Wren6991/RISCBoy-180/ip/gf180mcu_name_plate/image/name_plate.png

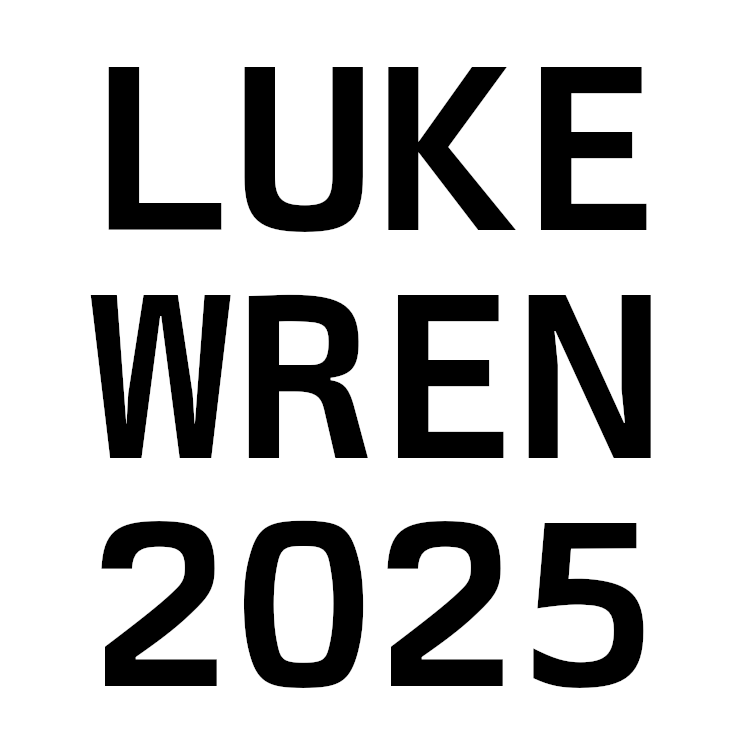
ip/gf180mcu_name_plate/image/name_plate.png
