Wren6991/RISCBoy-180/pcb/bringup/rb180-bringup.kicad_sch

## KiCad design pcb/bringup/rb180-bringup.kicad_sch (2026-06-28, an earlier design)

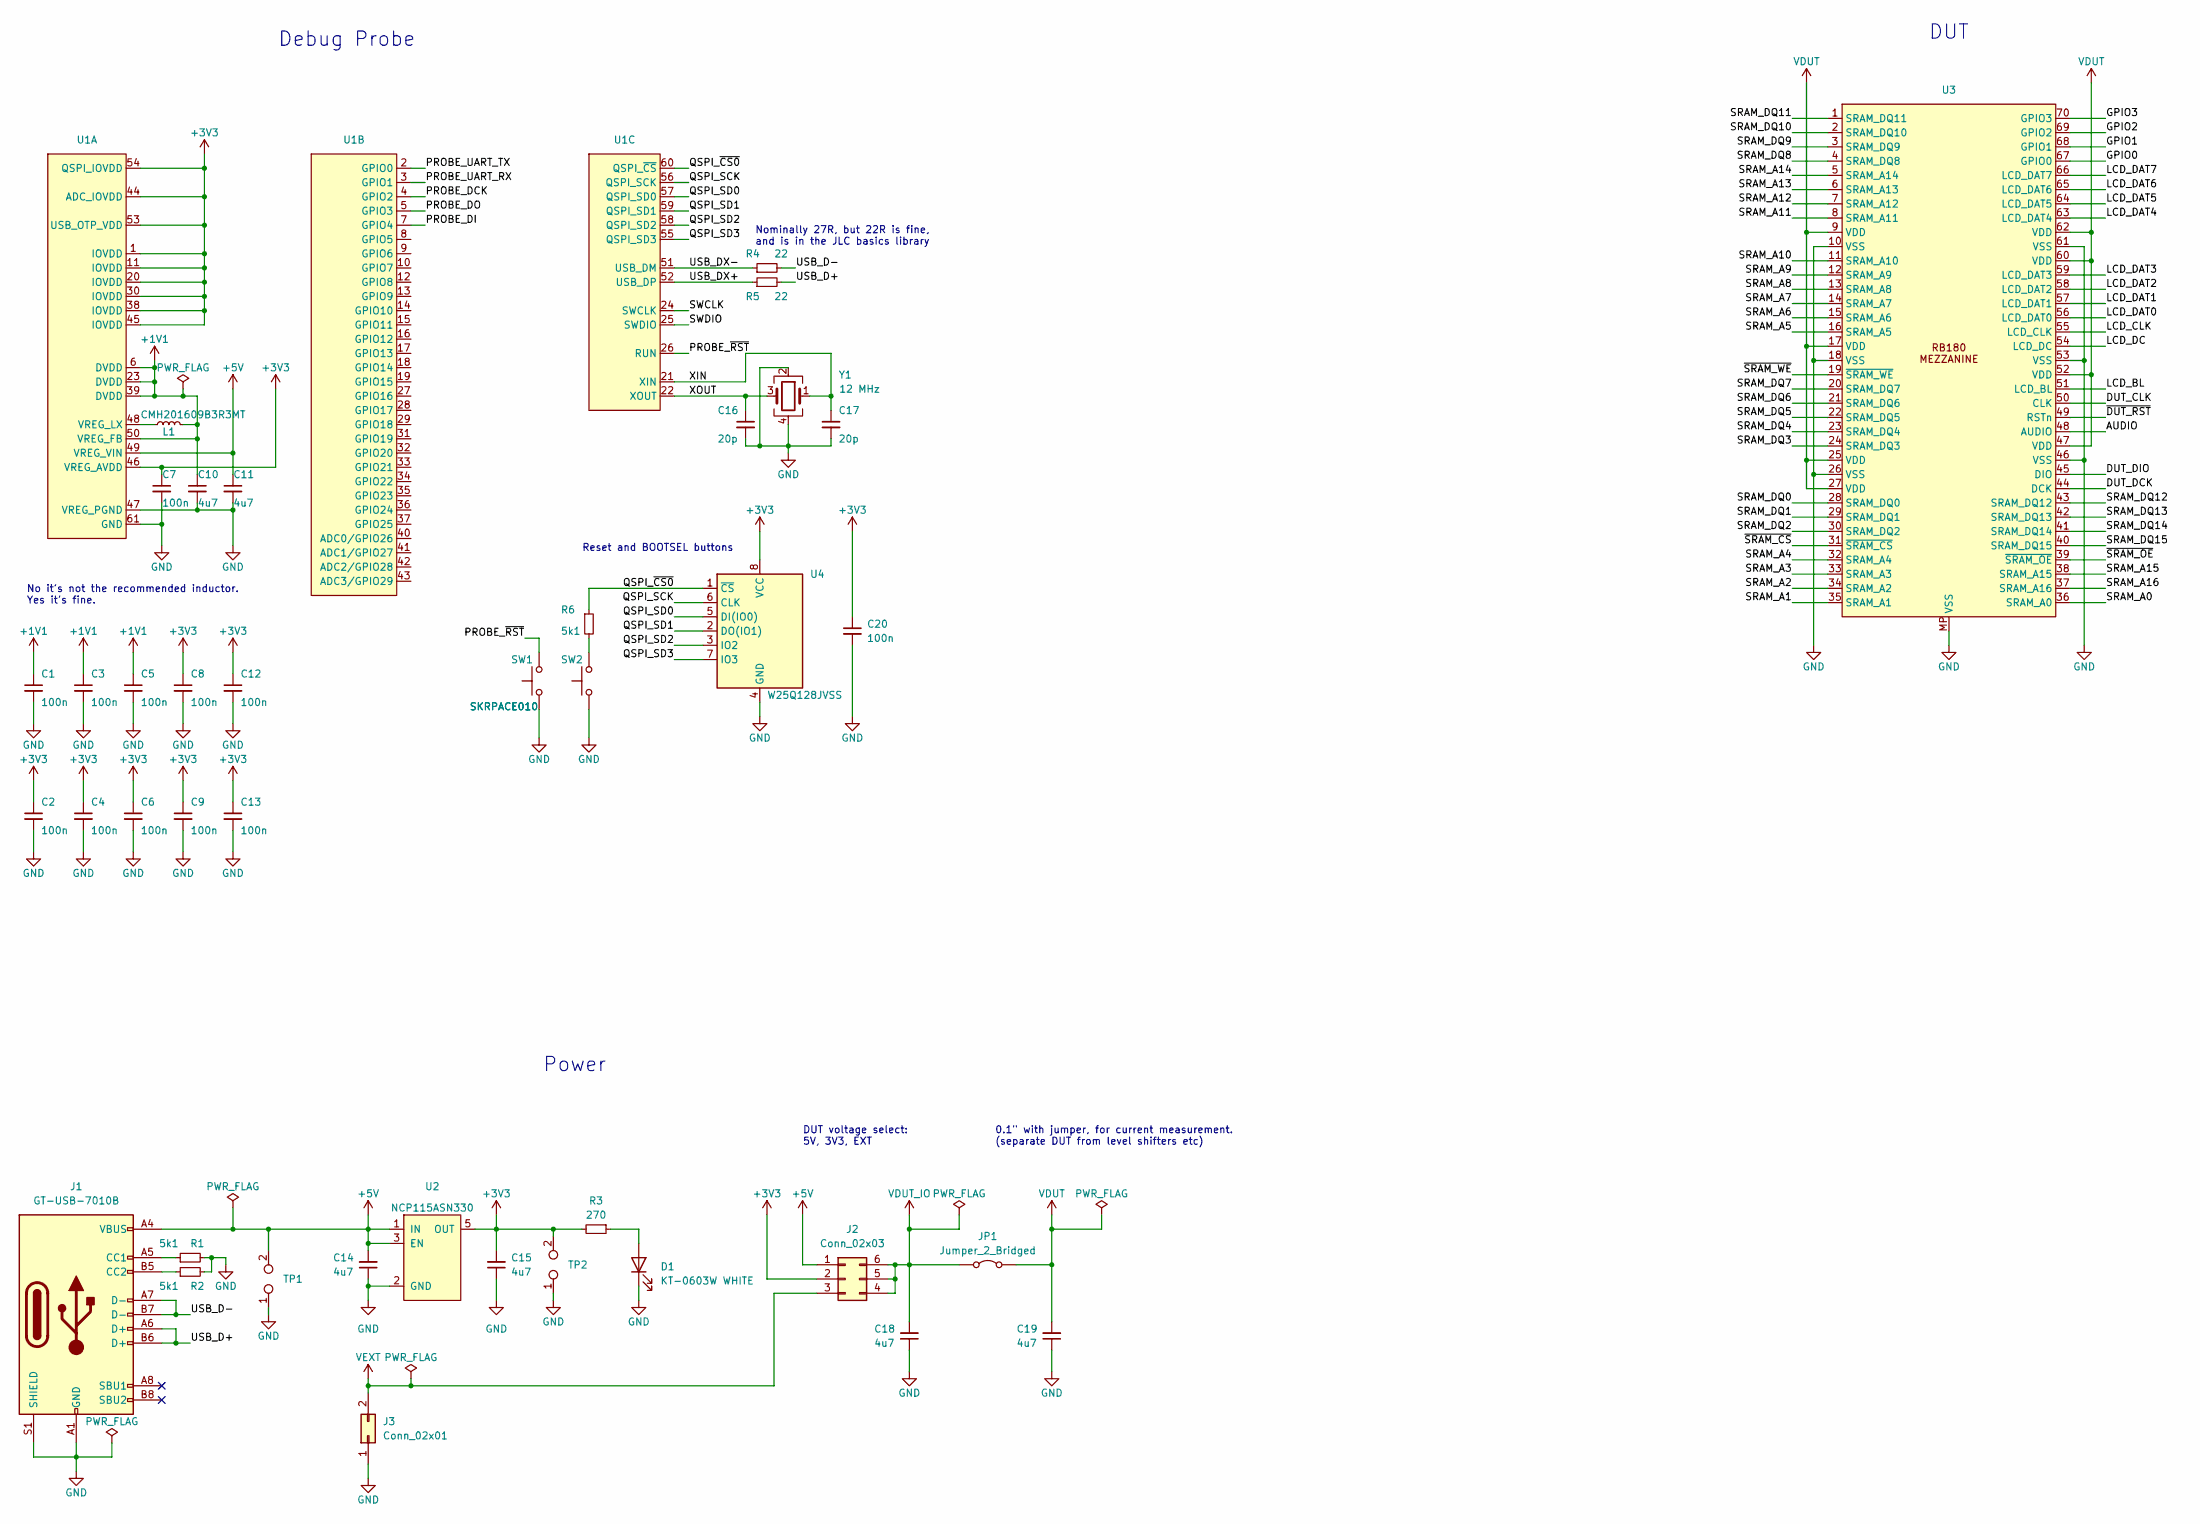
[picture p3: schematic rb180-bringup.kicad_sch]

Parts:
C1, C2, C3, C4, C5, C6, C7, C8, C9, C12, C13, C20: 100n; C_0402_1005Metric; LCSC C1525
C10, C11, C14, C15, C18, C19: 4u7; C_0402_1005Metric; LCSC C23733
C16, C17: 20p; C_0402_1005Metric; LCSC C1554
D1: KT-0603W WHITE; LED_0603_1608Metric; LCSC C2290
J1: GT-USB-7010B; USB_C_Receptacle_GT-USB-7010B; LCSC C2837092
J2: Conn_02x03
J3: Conn_02x01
JP1: Jumper_2_Bridged
L1: CMH201609B3R3MT; L_0805_2012Metric_Pad1.15x1.40mm_HandSolder; MPN CVH252009-3R3M; LCSC C3032602
R1, R2, R6: 5k1; R_0402_1005Metric; LCSC C294638
R3: 270; R_0402_1005Metric; LCSC C352448
R4, R5: 22; R_0402_1005Metric; LCSC C25092
SW1, SW2: SKRPACE010; SW_SPST_PTS815; LCSC C139797
TP1, TP2: TP_1x02_P1.00mm; LCSC DNP
U1, U3: (no value)
U2: NCP115ASN330; SOT-23-5; LCSC C603505
U4: W25Q128JVSS; SOIC-8_3.9x4.9mm_P1.27mm; LCSC C97521
Y1: 12 MHz; Crystal_SMD_3225-4Pin_3.2x2.5mm; LCSC C9002

Connections:
+1V1: C1.1, C3.1, C5.1, C10.1, L1.2, U1.6 (DVDD), U1.23 (DVDD), U1.39 (DVDD), U1.50 (VREG_FB)
+3V3: C2.1, C4.1, C6.1, C7.1, C8.1, C9.1, C12.1, C13.1, C15.2, C20.1, J2.2, R3.2, TP2.2, U1.1 (IOVDD), U1.11 (IOVDD), U1.20 (IOVDD), U1.30 (IOVDD), U1.38 (IOVDD), U1.44 (ADC_IOVDD), U1.45 (IOVDD), U1.46 (VREG_AVDD), U1.53 (USB_OTP_VDD), U1.54 (QSPI_IOVDD), U2.5 (OUT), U4.8 (VCC)
+5V: C11.1, C14.2, J1.A4 (VBUS), J1.A9 (VBUS), J1.B4 (VBUS), J1.B9 (VBUS), J2.1, TP1.2, U1.49 (VREG_VIN), U2.1 (IN), U2.3 (EN)
AUDIO: U3.48 (AUDIO)
DUT_CLK: U3.50 (CLK)
DUT_DCK: U3.44 (DCK)
DUT_DIO: U3.45 (DIO)
GND: C1.2, C2.2, C3.2, C4.2, C5.2, C6.2, C7.2, C8.2, C9.2, C10.2, C11.2, C12.2, C13.2, C14.1, C15.1, C16.2, C17.2, C18.1, C19.1, C20.2, D1.1 (K), J1.A1 (GND), J1.A12 (GND), J1.B1 (GND), J1.B12 (GND), J1.S1 (SHIELD), J3.1, R1.2, R2.2, SW1.1, SW2.1, TP1.1, TP2.1, U1.47 (VREG_PGND), U1.61 (GND), U2.2 (GND), U3.10 (VSS), U3.18 (VSS), U3.26 (VSS), U3.46 (VSS), U3.53 (VSS), U3.61 (VSS), U3.MP (VSS), U4.4 (GND), Y1.2, Y1.4
GPIO0: U3.67 (GPIO0)
GPIO1: U3.68 (GPIO1)
GPIO2: U3.69 (GPIO2)
GPIO3: U3.70 (GPIO3)
LCD_BL: U3.51 (LCD_BL)
LCD_CLK: U3.55 (LCD_CLK)
LCD_DAT0: U3.56 (LCD_DAT0)
LCD_DAT1: U3.57 (LCD_DAT1)
LCD_DAT2: U3.58 (LCD_DAT2)
LCD_DAT3: U3.59 (LCD_DAT3)
LCD_DAT4: U3.63 (LCD_DAT4)
LCD_DAT5: U3.64 (LCD_DAT5)
LCD_DAT6: U3.65 (LCD_DAT6)
LCD_DAT7: U3.66 (LCD_DAT7)
LCD_DC: U3.54 (LCD_DC)
unnamed: D1.2 (A), R3.1
unnamed: J1.A5 (CC1), R1.1
unnamed: J1.B5 (CC2), R2.1
unnamed: L1.1, U1.48 (VREG_LX)
unnamed: R6.2, SW2.2
PROBE_DCK: U1.4 (GPIO2)
PROBE_DI: U1.7 (GPIO4)
PROBE_DO: U1.5 (GPIO3)
PROBE_UART_RX: U1.3 (GPIO1)
PROBE_UART_TX: U1.2 (GPIO0)
PROBE_~RST: SW1.2, U1.26 (RUN)
QSPI_SCK: U1.56 (QSPI_SCK), U4.6 (CLK)
QSPI_SD0: U1.57 (QSPI_SD0), U4.5 (DI(IO0))
QSPI_SD1: U1.59 (QSPI_SD1), U4.2 (DO(IO1))
QSPI_SD2: U1.58 (QSPI_SD2), U4.3 (IO2)
QSPI_SD3: U1.55 (QSPI_SD3), U4.7 (IO3)
QSPI_~CS0: R6.1, U1.60 (QSPI_~CS), U4.1 (~CS)
SRAM_A0: U3.36 (SRAM_A0)
SRAM_A1: U3.35 (SRAM_A1)
SRAM_A2: U3.34 (SRAM_A2)
SRAM_A3: U3.33 (SRAM_A3)
SRAM_A4: U3.32 (SRAM_A4)
SRAM_A5: U3.16 (SRAM_A5)
SRAM_A6: U3.15 (SRAM_A6)
SRAM_A7: U3.14 (SRAM_A7)
SRAM_A8: U3.13 (SRAM_A8)
SRAM_A9: U3.12 (SRAM_A9)
SRAM_A10: U3.11 (SRAM_A10)
SRAM_A11: U3.8 (SRAM_A11)
SRAM_A12: U3.7 (SRAM_A12)
SRAM_A13: U3.6 (SRAM_A13)
SRAM_A14: U3.5 (SRAM_A14)
SRAM_A15: U3.38 (SRAM_A15)
SRAM_A16: U3.37 (SRAM_A16)
SRAM_DQ0: U3.28 (SRAM_DQ0)
SRAM_DQ1: U3.29 (SRAM_DQ1)
SRAM_DQ2: U3.30 (SRAM_DQ2)
SRAM_DQ3: U3.24 (SRAM_DQ3)
SRAM_DQ4: U3.23 (SRAM_DQ4)
SRAM_DQ5: U3.22 (SRAM_DQ5)
SRAM_DQ6: U3.21 (SRAM_DQ6)
SRAM_DQ7: U3.20 (SRAM_DQ7)
SRAM_DQ8: U3.4 (SRAM_DQ8)
SRAM_DQ9: U3.3 (SRAM_DQ9)
SRAM_DQ10: U3.2 (SRAM_DQ10)
SRAM_DQ11: U3.1 (SRAM_DQ11)
SRAM_DQ12: U3.43 (SRAM_DQ12)
SRAM_DQ13: U3.42 (SRAM_DQ13)
SRAM_DQ14: U3.41 (SRAM_DQ14)
SRAM_DQ15: U3.40 (SRAM_DQ15)
SWCLK: U1.24 (SWCLK)
SWDIO: U1.25 (SWDIO)
USB_D+: J1.A6 (D+), J1.B6 (D+), R5.2
USB_D-: J1.A7 (D-), J1.B7 (D-), R4.2
USB_DX+: R5.1, U1.52 (USB_DP)
USB_DX-: R4.1, U1.51 (USB_DM)
VDUT: C19.2, JP1.2 (B), U3.9 (VDD), U3.17 (VDD), U3.25 (VDD), U3.27 (VDD), U3.47 (VDD), U3.52 (VDD), U3.60 (VDD), U3.62 (VDD)
VDUT_IO: C18.2, J2.4, J2.5, J2.6, JP1.1 (A)
VEXT: J2.3, J3.2
XIN: C17.1, U1.21 (XIN), Y1.1
XOUT: C16.1, U1.22 (XOUT), Y1.3
~DUT_RST: U3.49 (RSTn)
~SRAM_CS: U3.31 (~SRAM_CS)
~SRAM_OE: U3.39 (~SRAM_OE)
~SRAM_WE: U3.19 (~SRAM_WE)

Notes on the sheet:
No it's not the recommended inductor. Yes it's fine.
Power
DUT voltage select: 5V, 3V3, EXT
Reset and BOOTSEL buttons
0.1" with jumper, for current measurement. (separate DUT from level shifters etc)
DUT
Debug Probe
Nominally 27R, but 22R is fine, and is in the JLC basics library
