Wren6991/RISCBoy-180/hdl/gpio/gpio.v

/*****************************************************************************\
|                        Copyright (C) 2025 Luke Wren                         |
|                     SPDX-License-Identifier: Apache-2.0                     |
\*****************************************************************************/

`default_nettype none

module gpio #(
	parameter N_GPIO = 13 // do not change without updating registers and SYS_FALSEPATH_MASK
) (
	input wire                clk,
	input wire                rst_n,
	
	// APB Port
	input  wire               apbs_psel,
	input  wire               apbs_penable,
	input  wire               apbs_pwrite,
	input  wire [15:0]        apbs_paddr,
	input  wire [31:0]        apbs_pwdata,
	output wire [31:0]        apbs_prdata,
	output wire               apbs_pready,
	output wire               apbs_pslverr,

	input  wire               audio,

	input  wire [7:0]         dispctrl_dat,

	input  wire               uart_tx,
	output wire               uart_rx,

	input  wire               spi_cs_n,
	input  wire               spi_sck,
	input  wire               spi_mosi,
	output wire               spi_miso,

	output wire [N_GPIO-1:0]  padout_gpio,
	output wire [N_GPIO-1:0]  padoe_gpio,
	input  wire [N_GPIO-1:0]  padin_gpio
);

// Set bits here for low-priority clk_sys paths that merge with higher
// priority paths on other clocks, to deprioritise the clk_sys path:
localparam SYS_FALSEPATH_MASK = 13'h1ff0;

// ----------------------------------------------------------------------------
// Connect alternate functions

wire [N_GPIO-1:0] alt_out = {
	audio,
	dispctrl_dat,
	1'b0, // miso
	spi_cs_n,
	spi_sck,
	spi_mosi
};

wire [N_GPIO-1:0] alt_oen  = {
	1'b1,  // audio
	8'hff, // lcd
	4'h7   // all but miso
};

// Note UART_TX appears on LCD_DAT3 when the display controller is in serial
// mode. It's controlled by the display controller's bus width and not part of
// this muxing.
assign uart_rx = padin_gpio[6]; // same as LCD_DAT2
assign spi_miso = padin_gpio[3];

// ----------------------------------------------------------------------------
// Register block

wire [N_GPIO-1:0] out_o;
wire              out_wen;
wire [N_GPIO-1:0] out_xor_o;
wire              out_xor_wen;
wire [N_GPIO-1:0] out_set_o;
wire              out_set_wen;
wire [N_GPIO-1:0] out_clr_o;
wire              out_clr_wen;

wire [N_GPIO-1:0] oen_o;
wire              oen_wen;
wire [N_GPIO-1:0] oen_xor_o;
wire              oen_xor_wen;
wire [N_GPIO-1:0] oen_set_o;
wire              oen_set_wen;
wire [N_GPIO-1:0] oen_clr_o;
wire              oen_clr_wen;

wire [N_GPIO-1:0] fsel_o;
wire              fsel_wen;
wire [N_GPIO-1:0] fsel_xor_o;
wire              fsel_xor_wen;
wire [N_GPIO-1:0] fsel_set_o;
wire              fsel_set_wen;
wire [N_GPIO-1:0] fsel_clr_o;
wire              fsel_clr_wen;

wire [N_GPIO-1:0] gpio_in;

// Actual registers aliased for write/XOR/set/clear:
reg  [N_GPIO-1:0] gpio_out;
reg  [N_GPIO-1:0] gpio_oen;
reg  [N_GPIO-1:0] fsel;

gpio_regs regs_u (
	.clk          (clk),
	.rst_n        (rst_n),

	.apbs_psel    (apbs_psel),
	.apbs_penable (apbs_penable),
	.apbs_pwrite  (apbs_pwrite),
	.apbs_paddr   (apbs_paddr),
	.apbs_pwdata  (apbs_pwdata),
	.apbs_prdata  (apbs_prdata),
	.apbs_pready  (apbs_pready),
	.apbs_pslverr (apbs_pslverr),

	.out_i        (gpio_out),
	.out_o        (out_o),
	.out_wen      (out_wen),
	.out_xor_i    (gpio_out),
	.out_xor_o    (out_xor_o),
	.out_xor_wen  (out_xor_wen),
	.out_set_i    (gpio_out),
	.out_set_o    (out_set_o),
	.out_set_wen  (out_set_wen),
	.out_clr_i    (gpio_out),
	.out_clr_o    (out_clr_o),
	.out_clr_wen  (out_clr_wen),

	.oen_i        (gpio_oen),
	.oen_o        (oen_o),
	.oen_wen      (oen_wen),
	.oen_xor_i    (gpio_oen),
	.oen_xor_o    (oen_xor_o),
	.oen_xor_wen  (oen_xor_wen),
	.oen_set_i    (gpio_oen),
	.oen_set_o    (oen_set_o),
	.oen_set_wen  (oen_set_wen),
	.oen_clr_i    (gpio_oen),
	.oen_clr_o    (oen_clr_o),
	.oen_clr_wen  (oen_clr_wen),

	.fsel_i       (fsel),
	.fsel_o       (fsel_o),
	.fsel_wen     (fsel_wen),
	.fsel_xor_i   (fsel),
	.fsel_xor_o   (fsel_xor_o),
	.fsel_xor_wen (fsel_xor_wen),
	.fsel_set_i   (fsel),
	.fsel_set_o   (fsel_set_o),
	.fsel_set_wen (fsel_set_wen),
	.fsel_clr_i   (fsel),
	.fsel_clr_o   (fsel_clr_o),
	.fsel_clr_wen (fsel_clr_wen),

	.in_i         (gpio_in)
);

// ----------------------------------------------------------------------------
// Output registers and muxing

always @ (posedge clk or negedge rst_n) begin
	if (!rst_n) begin
		gpio_out <= {N_GPIO{1'b0}};
		gpio_oen <= {N_GPIO{1'b0}};
		fsel     <= {N_GPIO{1'b0}};
	end else begin
		if (out_wen) begin
			gpio_out <= out_o;
		end else if (out_xor_wen) begin
			gpio_out <= gpio_out ^ out_xor_o;
		end else if (out_set_wen) begin
			gpio_out <= gpio_out | out_set_o;
		end else if (out_clr_wen) begin
			gpio_out <= gpio_out & ~out_clr_o;
		end
		if (oen_wen) begin
			gpio_oen <= oen_o;
		end else if (oen_xor_wen) begin
			gpio_oen <= gpio_oen ^ oen_xor_o;
		end else if (oen_set_wen) begin
			gpio_oen <= gpio_oen | oen_set_o;
		end else if (oen_clr_wen) begin
			gpio_oen <= gpio_oen & ~oen_clr_o;
		end
		if (fsel_wen) begin
			fsel <= fsel_o;
		end else if (fsel_xor_wen) begin
			fsel <= fsel ^ fsel_xor_o;
		end else if (fsel_set_wen) begin
			fsel <= fsel | fsel_set_o;
		end else if (fsel_clr_wen) begin
			fsel <= fsel & ~fsel_clr_o;
		end
	end
end

genvar g;
generate
wire [N_GPIO-1:0] padin_gpio_fp;
for (g = 0; g < N_GPIO; g = g + 1) begin: loop_g
	wire sys_out;
	wire sys_oen;
	wire fsel_fp;
	if (SYS_FALSEPATH_MASK[g]) begin: fp_g
		falsepath_anchor fp_io_u [3:0] (
			.i ({gpio_out[g], gpio_oen[g], fsel[g], padin_gpio[g]   }),
			.z ({sys_out,     sys_oen,     fsel_fp, padin_gpio_fp[g]})
		);
	end else begin: nofp_g
		assign {sys_out,     sys_oen,     fsel_fp, padin_gpio_fp[g]} =
		       {gpio_out[g], gpio_oen[g], fsel[g], padin_gpio[g]   };
	end
	assign padout_gpio[g] = fsel_fp ? alt_out[g] : sys_out;
	assign padoe_gpio[g]  = fsel_fp ? alt_oen[g] : sys_oen;
end
endgenerate

// ----------------------------------------------------------------------------
// Input synchronisers

sync_1bit gpio_in_sync_u [N_GPIO-1:0] (
	.clk   (clk),
	.rst_n (rst_n),
	.i     (padin_gpio_fp),
	.o     (gpio_in)
);

endmodule

`ifndef YOSYS
`default_nettype wire
`endif
