Wren6991/RISCBoy-180/(commit log)

2025-11-18 Yeet Hazard3 and SRAM into the chip.
    SRAM macro layout config will be completely wrong as I have no idea what hierarchical paths I'll get for generate loops
    [chip_core.sv, config.yaml]
2025-11-18 Apply blunt force until GDS. SRAM PDN connection is still wrong
    [ahb_sync_sram.v, chip_core.sv, config.yaml, sram_wrapper.v]
2025-11-18 Gets most of the way through, crashes on magic/klayout DRC XOR. Increased RAM to 8 kB. Timing is awful
    [chip_core.sv, config.yaml]
2025-11-18 Add Two-Wire Debug submodule
2025-11-18 Cut SBA to reduce address muxing complexity.
    We have other ways of getting a debug shell over TWD besides Segger RTT.
    Also tie off bit enables in memory wrapper, and just use global write
    enable. Memories are already 8 bits wide.
2025-11-19 Update pinout for chip_top to match RISCBoy interfaces.
    Update pad instances to match, with correct hierarchical names. Not yet updated padring config.
    Fix some issues in twowiredebug, and instantiate it in chip_core with appropriate clock and reset controls.
    Strip out some hardcoded junk from the .sdc
    [chip_core.sv, chip_top.sv, clkroot_anchor.v, config.yaml, falsepath_anchor.v]
2025-11-20 Fix up RISC-V debug python sim code and add a test for connecting to a core and checking the arch id.
    [chip_top_tb.py]
2025-11-20 Basic debug memory access test. Fix bug in behavioural RAM model.
    [chip_top_tb.py, sram_wrapper.v]
2025-11-20 Add RISCBoy and fpgascripts as submodules.
    Add reset_sync variant with a falsepath anchor on the input, to waive recovery violations when reset synchronisers are chained.
    [cell_clkgate_low.v, cell_clkxor.v, clkroot_anchor.v, falsepath_anchor.v, reset_sync.v]
2025-11-20 Add pad control registers, and a RISC-V timer instance.
2025-11-21 Instantiate RISCBoy external SRAM controller and add a flop PHY for it.
    Add some very dumb output constraints just to see if this is a viable way to get the flops placed next to the pads.
    Flip the IRAM macros so that the data channels are on the inside (previous changes did the opposite)
    [async_sram_phy_gf180mcu.v, audio_processor.v, cell_ddr_out.v, chip_core.sv, config.yaml]
2025-11-21 Minor script cleanup, and add hold margin as I'm seeing occasional failures on SRAM address hold from the short buffered address path
    [config.yaml]
2025-11-21 Revert "Another magic synthesis flag courtesy of Lofty"
    This reverts commit 66fa621ecdb70177a42124666420470255ff3dc0.
    Actually slightly degrades timing
    [config.yaml]
2025-11-22 Move palette RAMs back down; weirdly makes detailed router crash
    [config.yaml]
2025-11-22 TWD: add short-form status response to improve performance of polled IO.
    [chip_top_tb.py]
2025-11-22 Add PWM for LCD backlight
2025-11-22 Fix swapped gated/ungated clocks on processors
    [audio_processor.v, chip_core.sv]
2025-11-23 Swap to 9t cell library, and remove negedge thing from SRAM PHY (just pass the HWDATA through)
    [async_sram_phy_gf180mcu.v, cell_clkgate_low.v, cell_clkxor.v, clkroot_anchor.v, config.yaml, falsepath_anchor.v, reset_sync.v]
2025-11-23 Add missing power connections for PPU memories!
    [chip_core.sv]
2025-11-23 Add new VUART hardware for print to debugger
2025-11-24 Fix bug in aout PWM, and write a simple software header for aout
    [apu_aout.c, apu_sdm.v]
2025-11-24 Allow non-power-of-two total RAM depths in sram_wrapper
2025-11-24 Add additional straps to SRAM power connections
2025-11-24 Add APU timer peripheral
2025-11-25 Add GPIO control registers. Promote AUDIO pins to honourary GPIOs.
    Implement bit-banged SPI load in bootrom.
2025-11-25 Fix some wiring and constraints mistakes, and update notes
    [chip_core.sv]
2025-11-25 Add registered output to sea-of-gates ROM.
    Fix bugs in bootrom and reduce size.
    Add verilog static tb for running cocotb tests. Add SPI flash model.
    Bring up basic flash loading in cocotb tests.
    [bootrom.c, chip_top_tb.py, spi_flash_model.v, start_apu.c, tb.v]
2025-11-25 Register decoded address bits inside APB regblocks.
    Remove unnecessary reset from SBUS bridge in APU.
    [audio_processor.v]
2025-11-26 Fiddling with filter coefficients
2025-11-26 Use clock gates for LCD SPI SCK and SRAM WEn
2025-11-26 Apply reset to output enable of SRAM DQs
    [async_sram_phy_gf180mcu.v]
2025-11-26 New audio upsampling filter: more taps, fewer flops
2025-11-26 Fix SRAM Q outputs not being fully connected
    [sram_wrapper.v]
2025-11-27 Add tests for executing from external SRAM. Fix WEn coming out one cycle too early. oops
    [async_sram_phy_gf180mcu.v, byte_strobe.c, chip_top_tb.py, iram_addr_width.c, start_apu.c]
2025-11-27 Fix bad config for APU AHB splitter
    [audio_processor.v]
2025-11-27 Add false path on feedback loop from SRAM_DQ input to pulls. Force pull down at reset.
    [chip_top.sv]
2025-11-27 Copy huge macro halo config from upstream config.yaml, hopefully fixes my end-of-track DRCs from klayout
    [config.yaml]
2025-11-27 Fix some obvious mistakes in AOUT pipeline
    [apu_aout.v, apu_lowpass_filter.v]
2025-11-27 Add APB regblock change back in -- detailed router only seems to crash on MacOS.
    [apu_timer.v]
2025-11-27 Import UART from libfpga, add FIFO flush and IR output modulation.
    Instantiate one instance in core.
2025-11-27 Fix incorrect pull-down condition on SRAM DQs
    [chip_top.sv]
2025-11-27 Revert change to macro halo: is not the cause of my DRC issues and wastes a lot of important space around memories
    [config.yaml]
2025-11-27 Fix APU lowpass reset value now being midrail instead of ground
    [apu_lowpass_filter.v]
2025-11-27 First cut of SPI streaming peripheral
2025-11-27 Oops, fix up yosys presynth checks for new SPI
    [chip_core.sv, spi_stream.v]
2025-11-27 Align SPI pinout between streamer peripheral and the bootrom.
    Add don't-care to OOB bootrom addresses for minor logic savings.
2025-11-28 Add test for SPI read at different clock dividers, and fix some dumb mistakes.
    Add atomic set/clear/XOR for FSEL.
    [chip_top_tb.py, gpio.h, gpio.v, spi_flash_model.v]
2025-11-28 Fix pull-up for CSn at reset
    [gpio.v]
2025-11-28 Add test for pausing/unpausing. Fix missing chip select assert when exiting paused, busy state.
    [chip_top_tb.py, spi_stream.v, spi_stream_pause.c]
2025-11-28 Use SPI stream peripheral for flash load in bootrom.
    Fix unswapped endianness in SPI stream peripheral.
    [bootrom.c, chip_top_tb.py, spi_stream.v]
2025-11-28 Fix overread in bootrom
    [bootrom.c]
2025-11-29 Final attempt to tell OpenSTA the functional clocks are unrelated to the generator inputs (failed)
    [clocks.v]
2025-11-29 Fix up clock divisor in bootrom in anticipation of configurable generators going away
    [bootrom.c]
2025-11-29 Define GF180MCU for behav sims so we use inserted cells. Still using behavioural RAM model though.
2025-11-29 Updates to accommodate 8 LCD DAT pins:
    * Remove SRAM_UBn, SRAM_LBn and SRAM_A[17] pads
    * Remove dedicated LCD_CSn pad
    * Replace AUDIO_L, AUDIO_R pads with AUDIO
    * Remove GPIO[5] and GPIO[4] pads
    * Add 7 more LCD_DAT pads
    * Make LCD_DAT[7:0] software-controllable (including PU/PD/SCHMITT)
    * Reduce number of channels in APU AOUT from 2 to 1
    * Shrink total address map size to 512k (for new max 256k ERAM size)
    [apu_aout.v, audio_processor.v, chip_core.sv]
2025-11-29 Missing connection on LCD_DAT slew control
    [padctrl.v]
2025-11-30 Update async sram model to capture on correct edge
    [sram_async.v]
2025-12-01 Pull in some PPU code and port SPI display controller code to RB180 controller
2025-12-01 Lean on resizer until it actually does something (possibly not using the correct corners?)
    [config.yaml]
2025-12-01 Tidy up config.yaml, try inserting buffers in ABC
2025-12-01 tidy up tests a bit and hook up argument for filtering tests by name. Add address walk test for APU RAM.
2025-12-01 Fix incorrect start condition on START_APU register, and automatically release the bus if the debugger halts the APU (so that subsequent resume works)
    [apu_ipc.v, audio_processor.v]
2025-12-01 Break up large reset nets
    [audio_processor.v, chip_core.sv]
2025-12-01 Fix incorrect shift distance in dispctrl
    [riscboy_ppu_dispctrl_rb180.v]
2025-12-01 Add test for horizontal/vertical pixel doubling. Fix vertical doubling.
    [chip_core.sv, chip_top_tb.py, ppu_parallel_pixel_double.c, riscboy_ppu_dispctrl_rb180.v]
2025-12-01 Update RISCBoy to add one bit to PPU y counter.
    Add test for 1 x max-height frame, and fix PPU not rendering width-1 spans.
    [chip_top_tb.py, ppu_parallel_frame_height.c]
2025-12-02 Tighten up SRAM constraints and back off resizer setup margin now that timing is looking ok.
    Enable Zilsd/Zclsd on both cores as we seem to have the budget for it.
    [audio_processor.v, chip_core.sv, config.yaml]
2025-12-02 Add test for APU timer
2025-12-02 Make VUART FIFO return 0 when empty, to avoid X propagation from uninitialised FIFO flops. Use this to speed up the cocotb VUART host by 2x.
    [chip_top_tb.py, vuart.v]
2025-12-02 Use correct reset for main CPU
    [chip_core.sv]
2025-12-02 Replace vendor RAM models with simple behavioural ones without all the weird delay stuff.
    I already found two bugs in the vendor models, and there are still a couple of tests that fail when they are used. No time to diagnose unfortunately.
    [chip_top_tb.py, gf180mcu_fd_ip_sram__sram256x8m8wm1.v, gf180mcu_fd_ip_sram__sram512x8m8wm1.v]
2025-12-02 feat: pin the PDK version
2025-12-02 fix: add flatglob for sram128x8
    [config.yaml]
2025-12-02 Tweak logic density down to avoid detailed placement failure
    [config.yaml]
2025-12-03 Fix incorrect width for count update in spi_stream
    [spi_stream.v]
2025-12-03 Hazard3: Lint: waive unused parameters, and inhibit regfile writeback on stage 3 stall (shouldn't be necessary but makes me feel better)
2025-12-03 Fix cosmetic lint issues
    [ahb_sync_sram.v, apu_aout.v, apu_lowpass_filter.v, async_sram_phy_gf180mcu.v, audio_processor.v]
2025-12-03 Fix missing connection for PPU SRAM chicken bit
    [chip_core.sv]
2025-12-03 Delay SRAM chicken bit signals using flops on local reset synchronisers to avoid screwing up the placement quite so bad
    [audio_processor.v]
2025-12-03 Add test for RISC-V timer perioheral
2025-12-03 Oops, fix hole in name plate gds
2025-12-12 Tweak placement density after syncing latest PDK and flow config changes
    (was getting detailed placement failures; maybe need to actually do some
    logic optimisation)
    [config.yaml]
2025-12-12 Regenerate nameplate and manually fix metal hole again
2025-12-13 Fix bad merge in Makefile, and remove CTS_BALANCE_LEVELS which genuinely does nothing
    [config.yaml]
2025-12-13 Trim unnecessary datapath resets in spi_stream and ahb_sync_sram
    [ahb_sync_sram.v, spi_stream.v]
2025-12-14 Remove reset from datapath flops in APB bridge
    [chip_core.sv]
2025-12-14 Remove reset from counter and reload registers in APU timer
    [apu_timer.v]
2025-12-14 Fix up RAM initialisation in IRAM tests to match vendor model and my instance-level model
    [chip_top_tb.py]
2025-12-14 Add diode repair margin; seeing some minor M2 violations on logic, as well as major M5 violations on pad_DIO/PDRV1 and pad_DIO/PDRV0.
2025-12-14 Update Hazard3 to remove unnecessary resets on mw_result and timer mtime/mtimecmp registers
2025-12-14 Update riscboy RTL to strip out some more datapath resets (probably done now).
    Increase target placement density
    [config.yaml]
2025-12-18 Insert antenna diodes on falsepathed DIO pad controls prior to detailed routing
2026-06-24 Add requirements for bringup board
2026-06-25 More detail in bringup board spec
2026-06-25 More detail in bringup board spec, some part selection.
2026-06-26 Add symbol for mezzanine connector with RB180 pin labels
2026-06-27 Start drawing schematic. Add DUT, probe (RP2350) and power chain + USB.
    [rb180-bringup.kicad_pcb, rb180-bringup.kicad_sch]
2026-06-27 Add async parallel SRAM symbol and wire it up to DUT
    [rb180-bringup.kicad_sch]
2026-06-27 Add level shifters
    [rb180-bringup.kicad_sch]
2026-06-27 Add LCD header and control muxing jumpers
    [rb180-bringup.kicad_sch]
2026-06-28 Mostly feature-complete
    [rb180-bringup.kicad_sch]
2026-06-28 Add audio output and push buttons
    [rb180-bringup.kicad_sch]
2026-06-28 Fix some ERCs
    [rb180-bringup.kicad_sch]
